CodedCreator/Quantum-Dice/README.md

# QuantumDice by UTwente

flyer

In this repo you can find all relevant files, including assembly instructions, 3D printing files, and the parts list. Based on this information, you can build the Quantum Dice yourself.

For further information see [Quantum Dice by University of Twente](https://www.utwente.nl/en/mesaplus/education/quantum-dice/)

You can find more information about the dice in our article, including didactical approaches, for which a preprint is available on [*arXiv*](https://arxiv.org/abs/2510.04931)

Content of this repo:

- [Arduino Code](/QuantumDice/)
- [Firmware upload procedure](/SETUP.md)
- [3D printfiles](/3D%20print%20files/)
- [Construction manual](/3D%20print%20files/ConstructionManual.md)
- [Bill of Material and parts sourcing calculator](/3D%20print%20files/Bill%20of%20Material%20quantum%20dice.xlsx)
- [Arduino Technical documentation](/QuantumDice/technical%20documentation.md) and [Installation and configuration Arduino IDE](Arduino/QuantumDice/README.md)

## Contribution

Your contribution is welcome and appreciated to improve the quality and functionality of the Quantum Dice.
