CodedCreator/Quantum-Dice/images/Copy macAddress.png

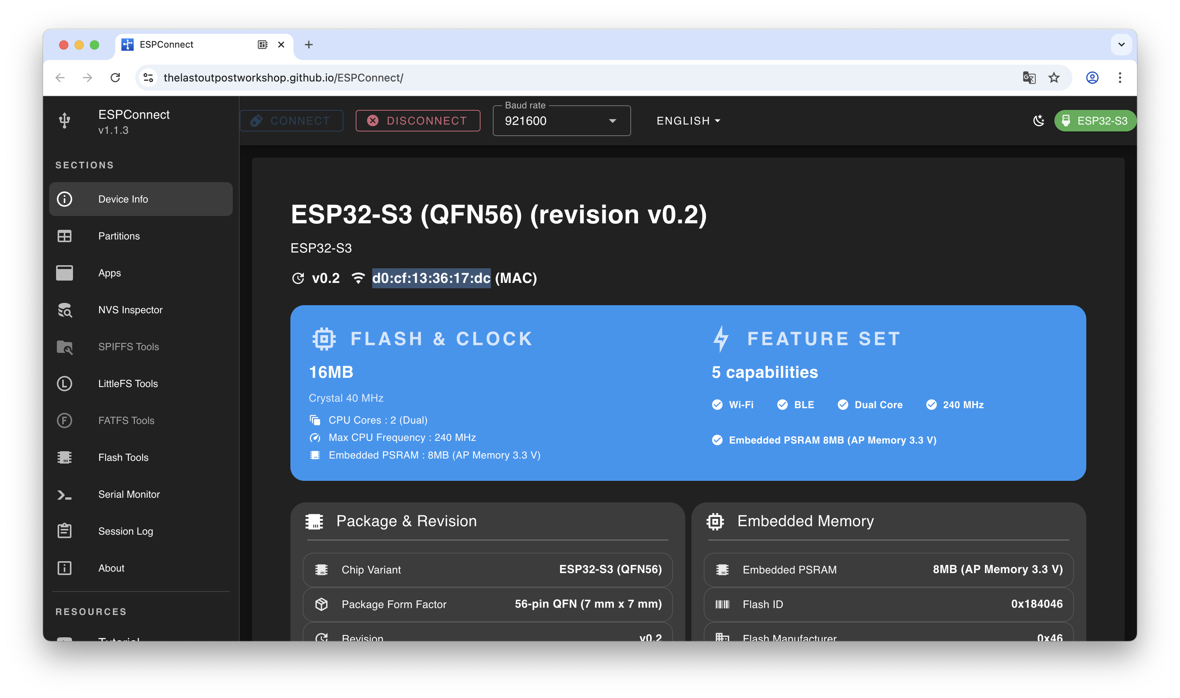
images/Copy macAddress.png
