CodedCreator/Quantum-Dice/images/flash firmware.png

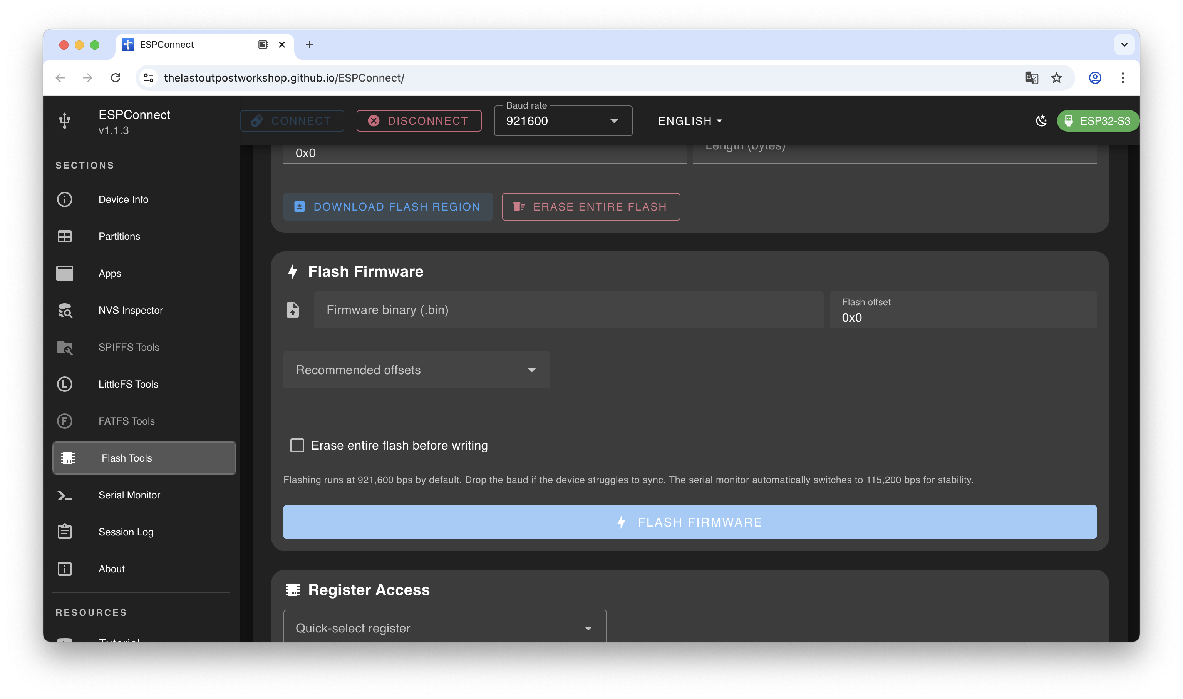
images/flash firmware.png
