CodedCreator/Quantum-Dice/images/flash partition.png

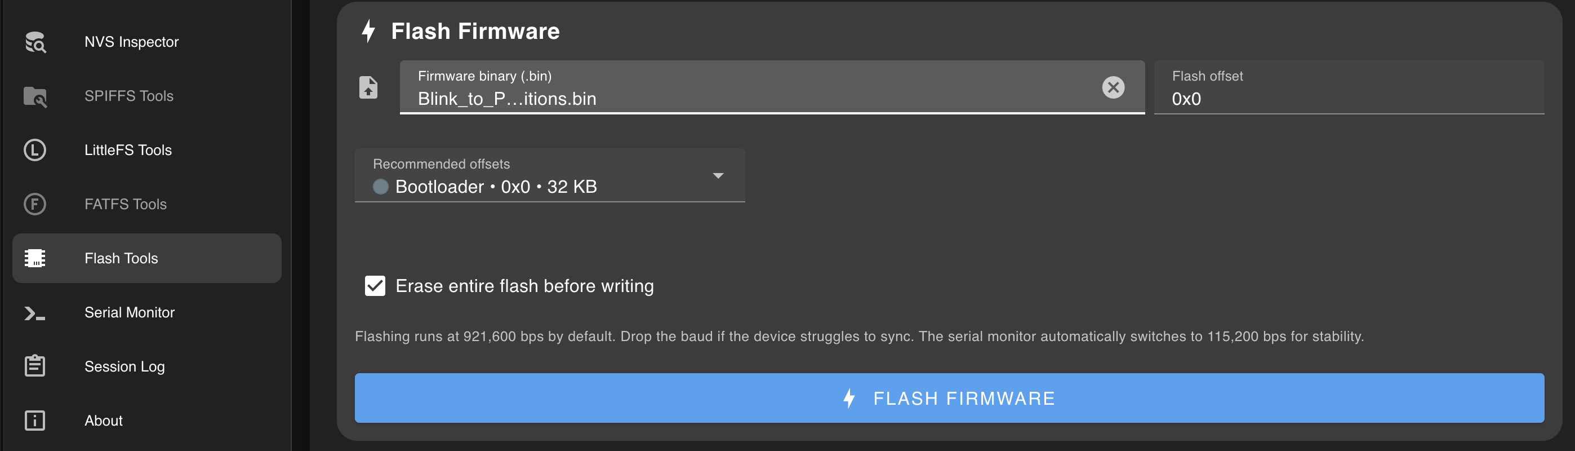
images/flash partition.png
