CodedCreator/Quantum-Dice/images/Flash_quantumDice_binary.png

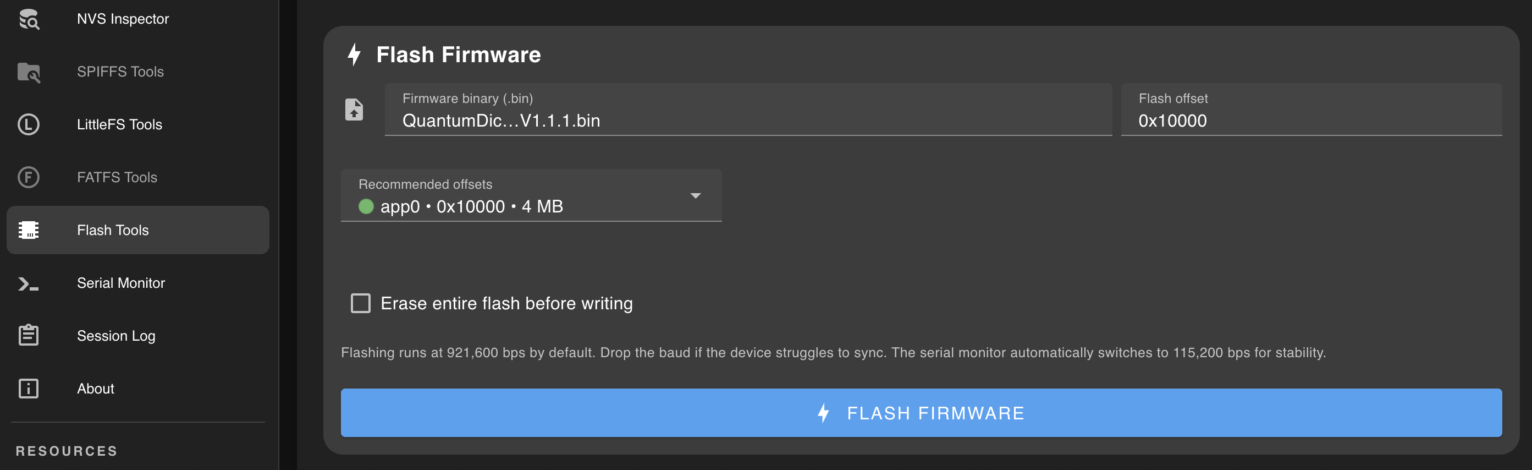
images/Flash_quantumDice_binary.png
