CodedCreator/Quantum-Dice/images/LittleFS confirm.png

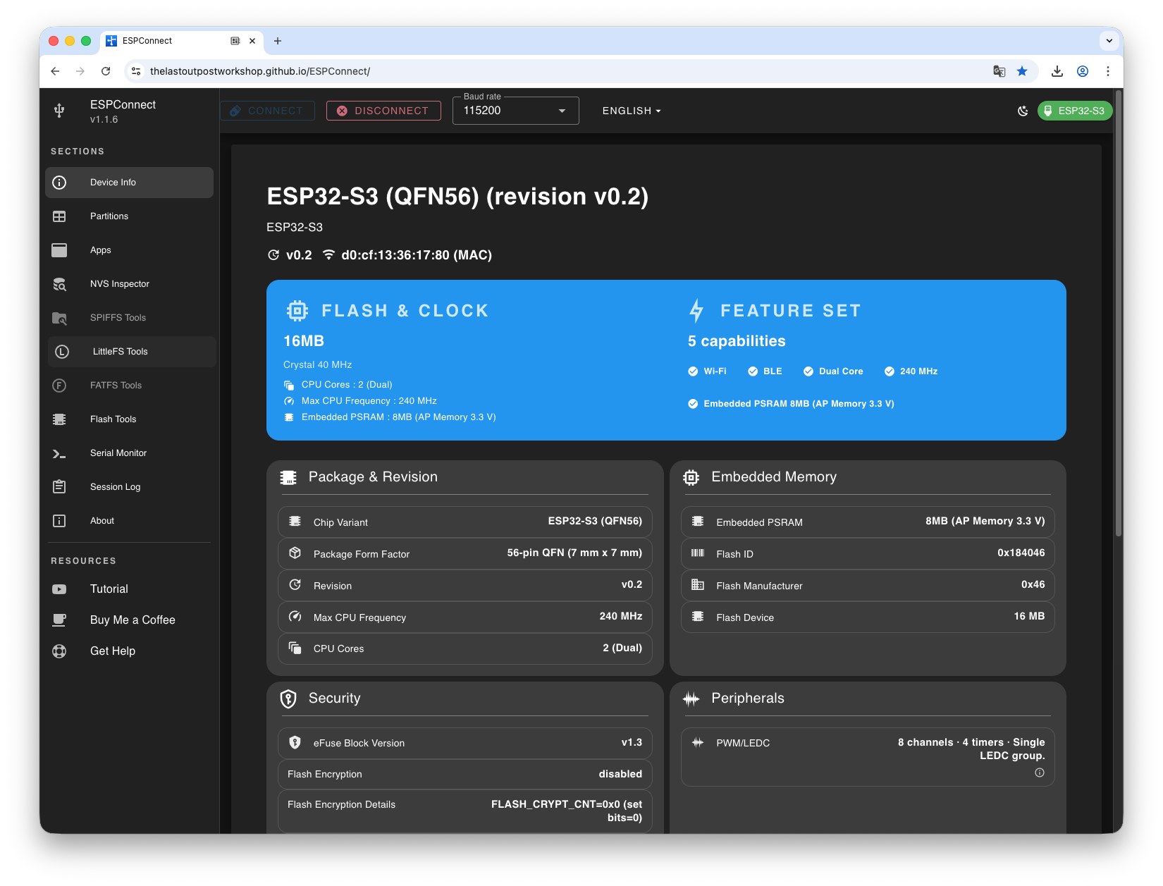
images/LittleFS confirm.png
