CodedCreator/Quantum-Dice/images/Opening_screen_ESPConnect - Select serial port.png

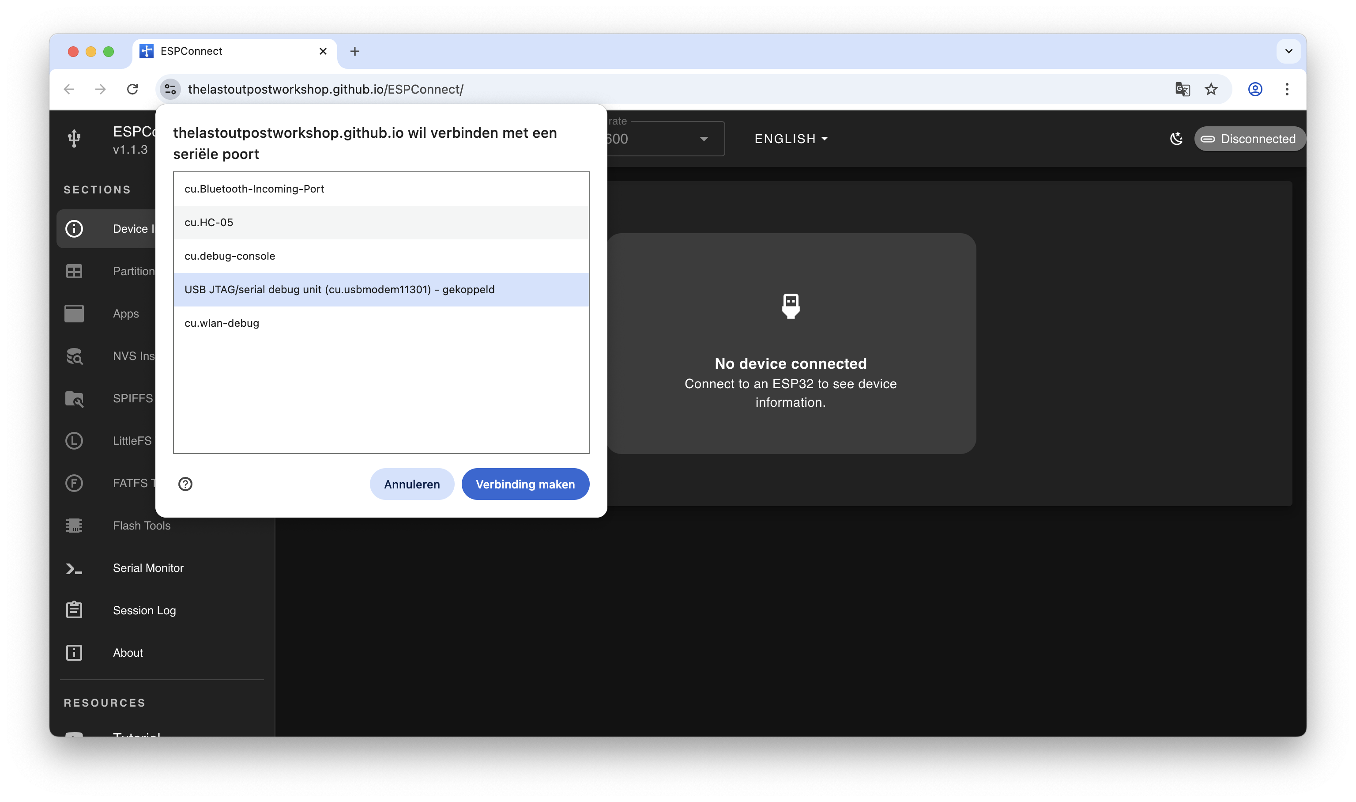
images/Opening_screen_ESPConnect - Select serial port.png
