CodedCreator/Quantum-Dice/images/Opening_screen_ESPConnect.png

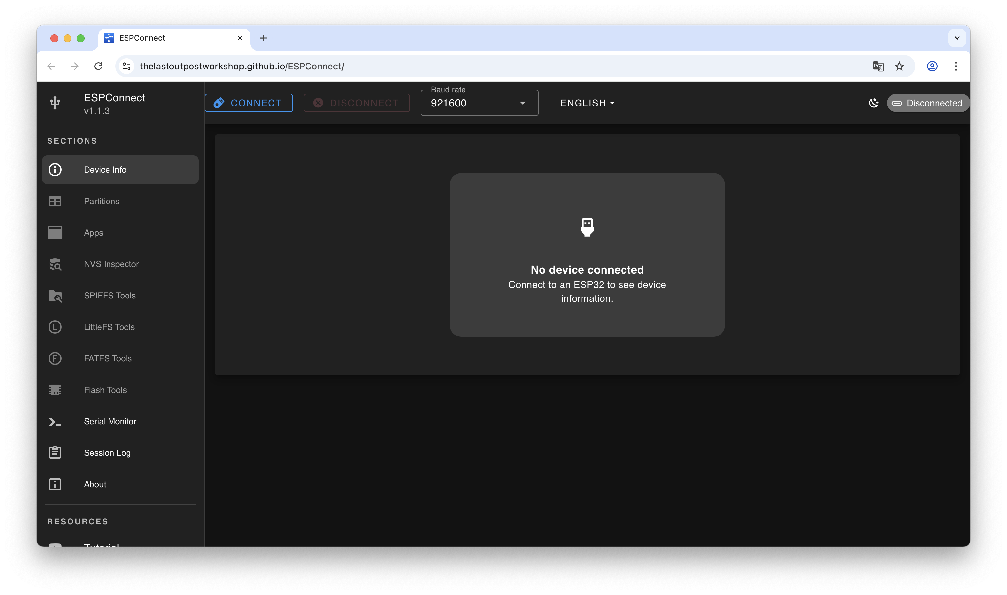
images/Opening_screen_ESPConnect.png
