CodedCreator/Quantum-Dice/images/Partition_layout.png

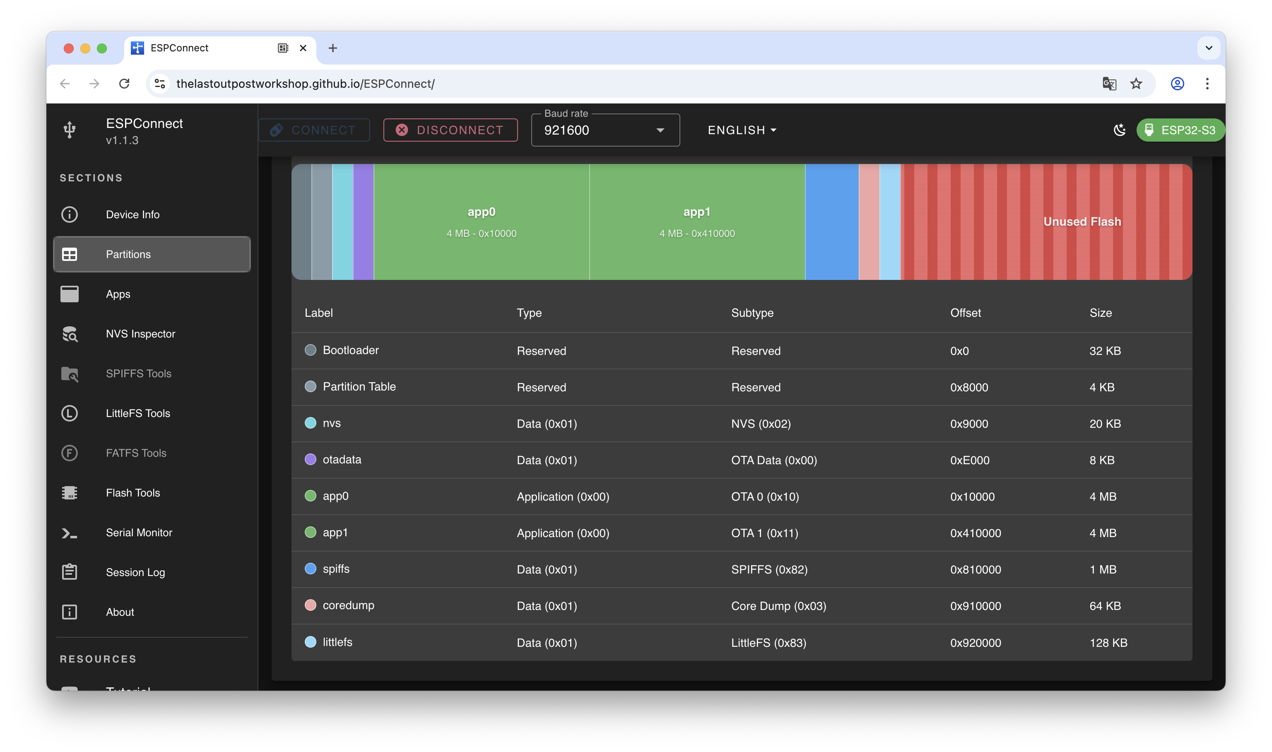
images/Partition_layout.png
