CodedCreator/Quantum-Dice/images/SerialMonitor confirm.png

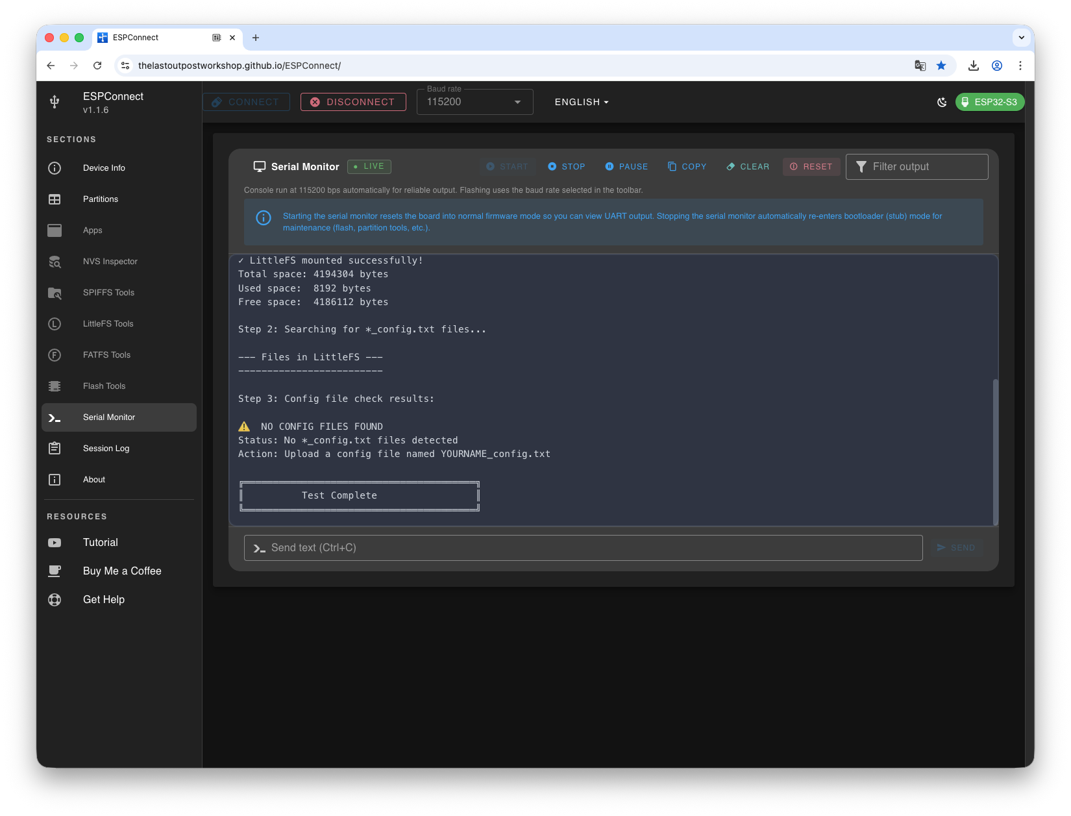
images/SerialMonitor confirm.png
