CodedCreator/Quantum-Dice/PCB files/QuantumDice_ESP32PCB v3.2/BOM_QuantumDiceV3.2.xls

Comment | Designator | Footprint | JLCPCB Part #
BX-XH2.54-4PLT | J8 |  | C18077883
100pF | C6 |  | C1790
100nF | C2,C13,C3,C5,C14 | CC0805KRX7R9BB104 | C49678
ESD5451N | D2,D3,D4 |  | C239604
Z- | J6,J7,J3,J2,J1,J5 |  | C262301
1uF | C7,C4 |  | C24123
USBC_RVE | J4 |  | C2765186
0R | R1,R13 | 0805W8F0000T5E | C17477
2.2uF | C8 |  | C19110
TS-1101-C-W | S2,S3 |  | C318938
10uF | C1,C9 |  | C15850
10k | R3,R5,R2,R4,R11,R12,R10,R6,R7,R15 | 0805W8F1002T5E | C17414
ESP32-S3-WROOM-1-N16R8 | IC1 |  | C2913202
B5819WS | D1 |  | C22624
AP2210K-3.3TRG1 | IC4 |  | C176959
5.1K | R9,R8 | 0805W8F5101T5E | C27834
0603WAF5100T5E | R14 | RC0603FR-07100RL | C23193
NCD0603G1 | LD1 |  | C84267
BNO055 | U1 |  | C93216
Q13MC1462000200 | Y1 |  | C2764505
CL10C220JB8NNNC | C10,C12 |  | C1653
