CodedCreator/Quantum-Dice/3D print files/QuantumDice V2 PrintParts/sideplate with battery holder and charging socket PLA yellow.STL

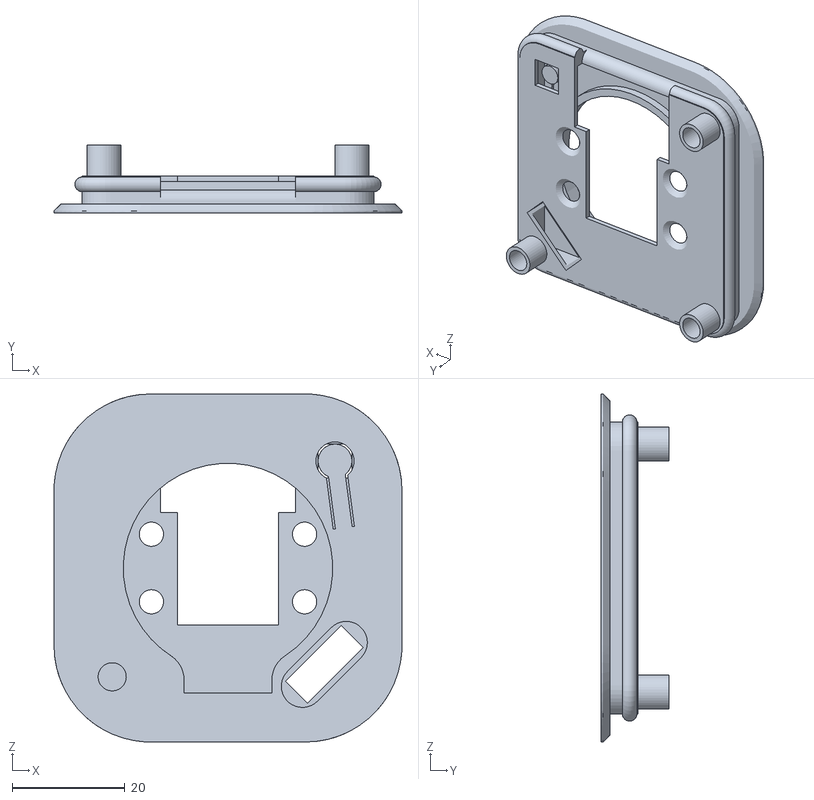
[picture p10: CAD file, 2026-01-27]
3D print files/QuantumDice V2 PrintParts/sideplate with battery holder and charging socket PLA yellow.STL
61.8 x 12.1 x 61.8
