CodedCreator/Quantum-Dice/3D print files/QuantumDice V2 PrintParts/die shell bottom TPU Black.STL

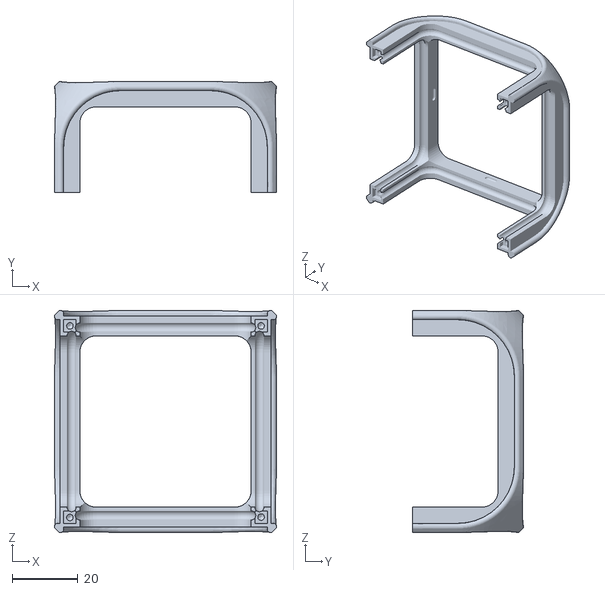
[picture p11: CAD file, 2026-01-27]
3D print files/QuantumDice V2 PrintParts/die shell bottom TPU Black.STL
67.4 x 33.7 x 67.4
