CodedCreator/Quantum-Dice/3D print files/QuantumDice V2 PrintParts/charging port PLA Black.STL

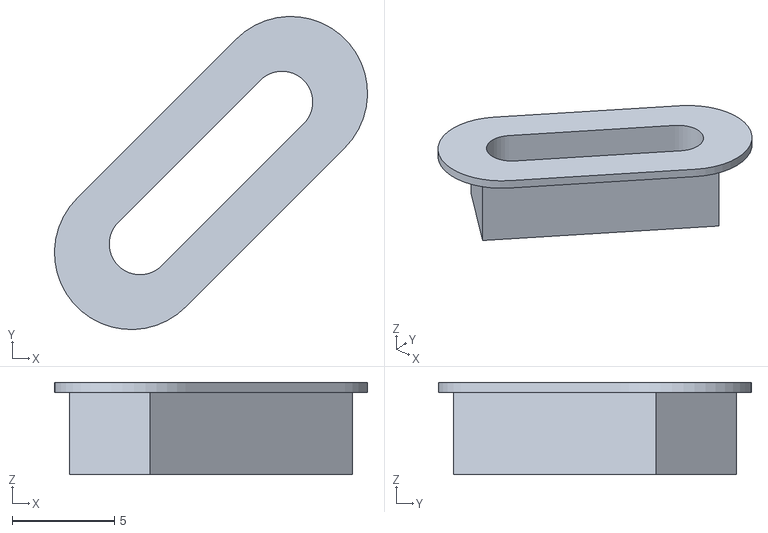
[picture p12: CAD file, 2026-01-27]
3D print files/QuantumDice V2 PrintParts/charging port PLA Black.STL
15.3 x 15.3 x 4.50
