CodedCreator/Quantum-Dice/3D print files/QuantumDice V2 PrintParts/sideplate PLA Red.STL

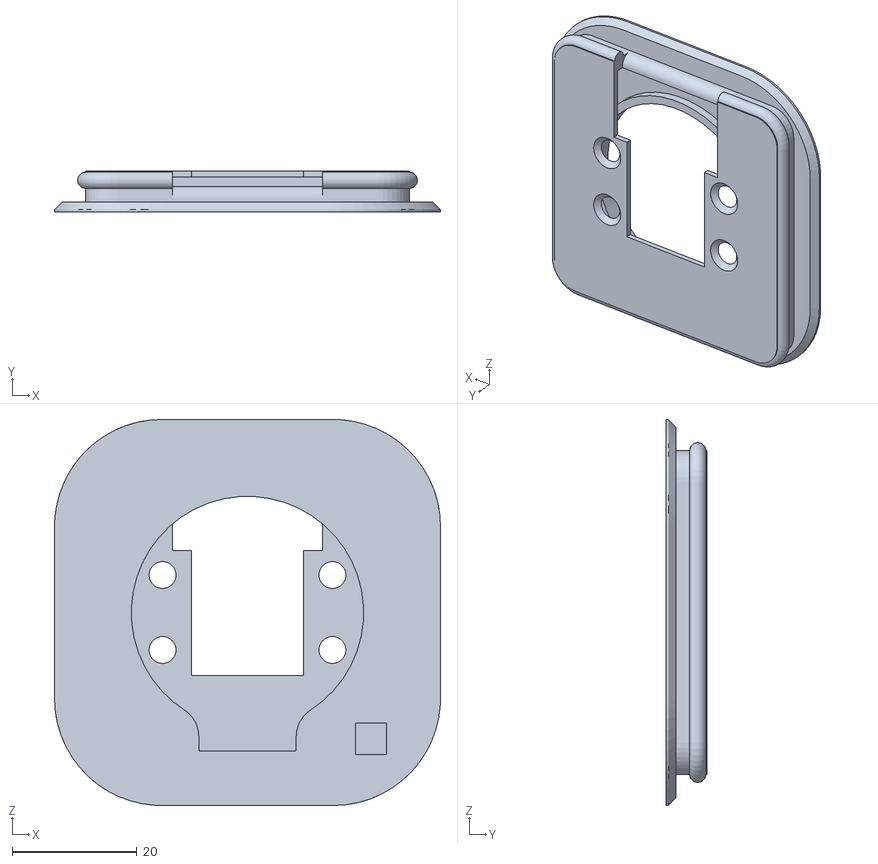
[picture p14: CAD file, 2026-01-27]
3D print files/QuantumDice V2 PrintParts/sideplate PLA Red.STL
61.8 x 6.60 x 61.8
