CodedCreator/Quantum-Dice/3D print files/QuantumDice V2 PrintParts/die shell top with screw TPU BLack.STL

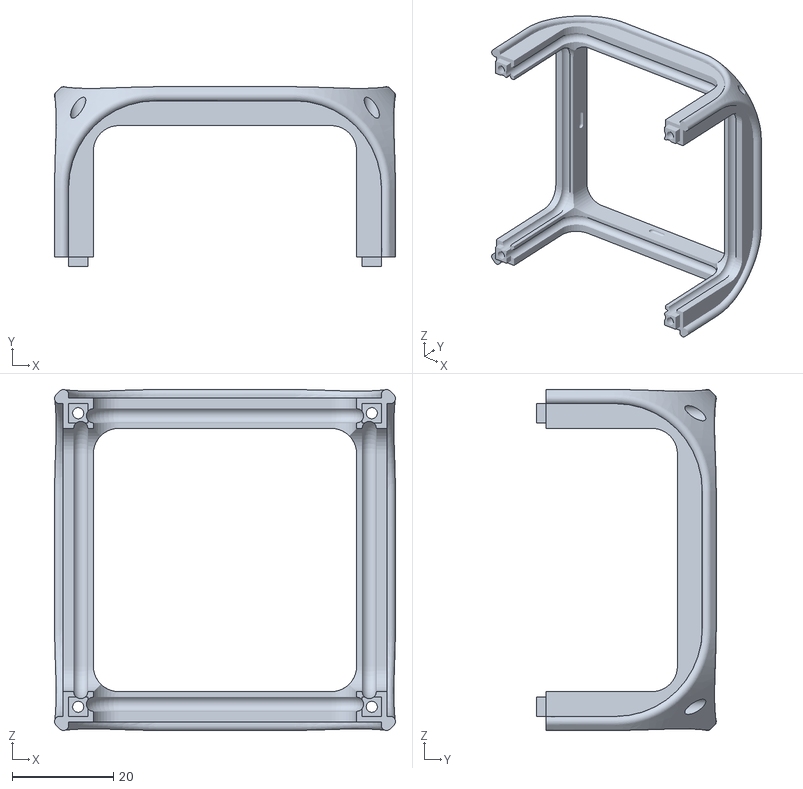
[picture p15: CAD file, 2026-01-27]
3D print files/QuantumDice V2 PrintParts/die shell top with screw TPU BLack.STL
67.4 x 35.5 x 67.4
