CodedCreator/Quantum-Dice/(list of files, cad)

Other CAD files:
3D print files/QuantumDice V2 PrintParts/sideplates with battery holder PLA Yellow.STL
