CodedCreator/Quantum-Dice/3D print files/README.md

> NOTE: **This instruction manuals where made for the v1.X.X version of the dice. You may need to adapt some steps for them work with the v2.X.X verion.

# QuantumDice by UTwente building the dice

In this directory you will find the 3D printfiles to build the quantum dice. Detailled [Construction and assembly manual](ConstructionManual.md).

Next to that a Bill of Material (Excel file) with both 3D print files and electronic components needed to build a set of quantum dice, including sourcing references
