CodedCreator/Quantum-Dice/(commit log)

2025-11-17 Remove ATECC hardware RNG and switch to ESP32 RNG
    Replaced the ATECCX08A hardware random number generator with the ESP32's internal esp_random() function throughout the QuantumDice firmware and documentation. Removed all references, initialization, and configuration code for the ATECC chip in both the main dice and initialization tool. Updated technical documentation to reflect the change in random number source. Incremented firmware version to 1.1.1.
    [BOM_QuantumDiceV3.2.xls, PickPlace_QuantumDiceV3.2.csv]
2025-12-26 updataes to new IMUHelper
2025-12-27 Updata BNO055 IMUHelper
2025-12-28 Clean up branch
    [partitions.csv]
2025-12-29 Implementation of config reading from config file in littleFS
    [TEST1_config.txt, partitions.csv]
2026-01-05 documentation library
    [TEST1_config.txt]
2026-01-05 Add an include for IMUhelpers.h in handyHelpers.h
2026-01-05 Added a base case return for functions selectOneToSix() and selectOppositeOneToSix(DiceNumbers)
2026-01-18 Removed fixed MAC addresses and roles
    [StateMachine.cpp]
2026-01-19 revert of entanglement color
    The remainings of this function like screen states are still present
    [StateMachine.cpp]
2026-01-19 Update DiceStateGenerators v2.xlsx
    [DiceStateGenerators v2.xlsx]
2026-01-19 Tweaking IMU parameters
2026-01-20 Add setup mode and config validation to QuantumDice
    Introduces auto-initialization and validation functions for configuration and LittleFS in DiceConfigManager. Adds setup mode detection and display, including functions to show config mode on screens and enter safe setup mode if configuration is missing or invalid. Removes BasicExample_littleFS and Blink_to_Partitions example files and related build artifacts. Updates README and configuration templates. Refactors StateMachine for improved formatting and clarity.
    [TEST1_config.txt, partitions.csv]
2026-01-20 Add DEV1 config, improve config parsing, update logs
    Added DEV1_config.txt for new device configuration. Improved DiceConfigManager to strip inline comments from config values. Updated QuantumDice.ino to log isSMD connection type. Updated TEST1_config.txt with new MAC addresses.
    [DEV1_config.txt]
2026-01-21 Added a sketch.yml file for easy compilation using the arduino-cli.
2026-01-23 Added random entanglement colours and updated teleportation protocol to use these
    [DEV1_config.txt, TEST1_config.txt]
2026-01-23 Made entanglement colours toggleable
    [DEV1_config.txt, TEST1_config.txt]
2026-01-23 Removed unused config keys
    [DEV1_config.txt, TEST1_config.txt]
2026-01-23 Changed arduino-cli commands so that they use multiple cores, if any are available
2026-01-26 Fixed bug where entanglement colour is not properly stored
    [StateMachine.cpp, StateMachine.hpp]
2026-01-26 Fixed bug where the screen would flash when receiving measurements
    [StateMachine.cpp]
2026-01-27 Merged init and program sketch and updated docs
    [DEV1_config.txt, DiceStateGenerators v2.xlsx, TEST1_config.txt, partitions.csv]
2026-01-27 Added low battery mode transition
2026-01-27 Added new 3D printing files
    [charging port PLA Black.STL, die shell bottom TPU Black.STL, die shell top with screw TPU BLack.STL, sideplate PLA Red.STL, sideplate with battery holder and charging socket PLA yellow.STL, sideplate with snapfit PLA blue.STL, sideplates with battery holder PLA Yellow.STL]
